30350n/spark-inducer/README.md

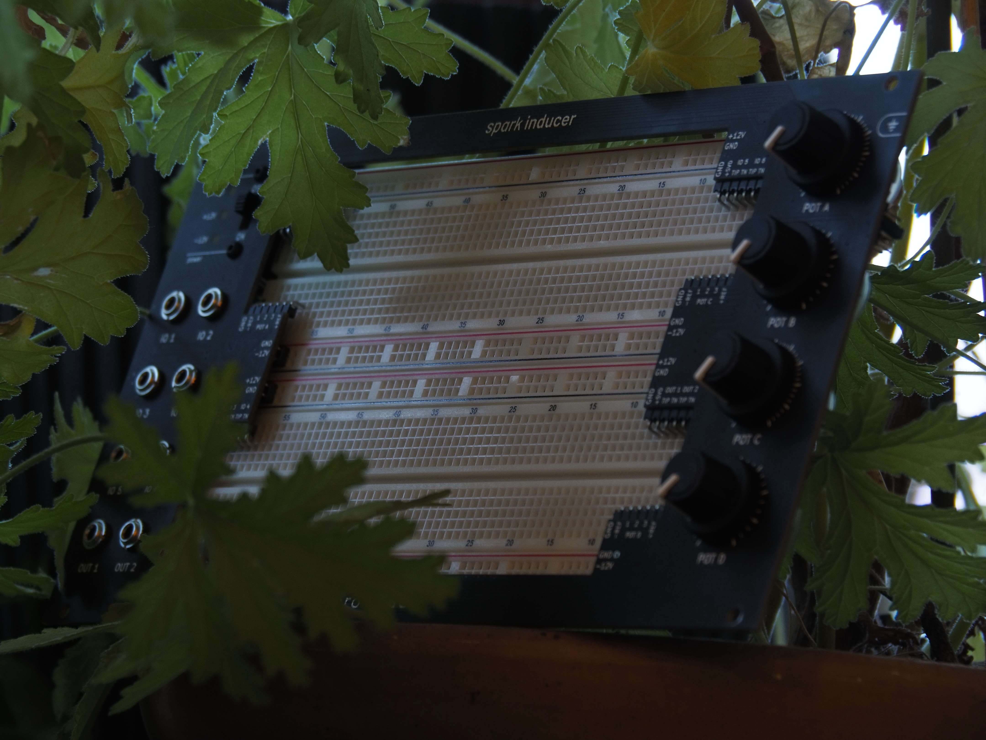
[picture p1: images/dev_C230025_assembled_nature.jpg]


### [More info](https://protorack.de/modules/spark-inducer)

### [Support me by buying a Kit at LECTRONZ!](https://lectronz.com/products/spark-inducer)
