30350n/spark-inducer/(threads)

Thread 1 (2024-02-17):

3D printed plastic bracket for power switch

drbloop, 2024-02-17:
Can you add a STL file for the power switch bracket to this repository? I am assembling spark-inducer from a PCB/panel set and am stuck on Step 3.1 in the assembly manual. I have access to a 3D printer, just need the STL file. Thank you.

30350n, 2024-02-21:
Hey, sorry for the late answer!

Here's the FreeCAD files, aswell as STL files for both Spacers. These should really be included in this repository, I'll add them the next days. Is will also include them with PCB/Panel Kits in the future, there's really no reason not to (I just didn't think of it).

[Spacer_GF-161-3011_M2-5_2.zip](https://github.com/30350n/spark-inducer/files/14365993/Spacer_GF-161-3011_M2-5_2.zip)
[Washer_RV16AF_2mm_3.zip](https://github.com/30350n/spark-inducer/files/14365982/Washer_RV16AF_2mm_3.zip)

drbloop, 2024-02-22:
Thank you, printed from these files and no problems - everything fits together perfectly.

30350n, 2024-02-23:
That's very nice to hear! If you run into any other issue with the build be sure to hit me up 😃

Thread 2 (2025-03-02):

LFO schematic?

unfrostedpoptart, 2025-03-02:
Hi.

I just got your kit and built it.  The main unit is fine but the LFO isn't working and I  can't find the schematic for it.  Where is it?

Thanks,

David

30350n, 2025-03-02:
Hi! The sources for the P-02 LFO are available [here](https://github.com/30350n/breadboard-helpers/tree/master/P-02_lfo).

If  you want you can also share a picture of it here, maybe I can spot something ^^

unfrostedpoptart, 2025-03-02:
Thanks, but those are all KiCAD files - which I don’t have. Don’t you have a PDF of the schematic?Sent from my iPhoneOn Mar 2, 2025, at 6:51 AM, Bobbe ***@***.***> wrote:
  Hi! The sources for the P-02 LFO are available here.
If  you want you can also share a picture of it here, maybe I can spot something ^^—Reply to this email directly, view it on GitHub, or unsubscribe.You are receiving this because you authored the thread.Message ID: ***@***.***>

30350n left a comment (30350n/spark-inducer#2)
Hi! The sources for the P-02 LFO are available here.
If  you want you can also share a picture of it here, maybe I can spot something ^^

—Reply to this email directly, view it on GitHub, or unsubscribe.You are receiving this because you authored the thread.Message ID: ***@***.***>

30350n, 2025-03-02:
Here you go: [P-02_lfo.pdf](https://github.com/user-attachments/files/19044056/P-02_lfo.pdf)

unfrostedpoptart, 2025-03-02:
thanksSent from my iPhoneOn Mar 2, 2025, at 9:25 AM, Bobbe ***@***.***> wrote:
  Here you go: P-02_lfo.pdf—Reply to this email directly, view it on GitHub, or unsubscribe.You are receiving this because you authored the thread.Message ID: ***@***.***>

30350n left a comment (30350n/spark-inducer#2)
Here you go: P-02_lfo.pdf

—Reply to this email directly, view it on GitHub, or unsubscribe.You are receiving this because you authored the thread.Message ID: ***@***.***>

Closed 2025-03-07.
