30350n/spark-inducer/manual/manual.pdf

## Potentiometers

!

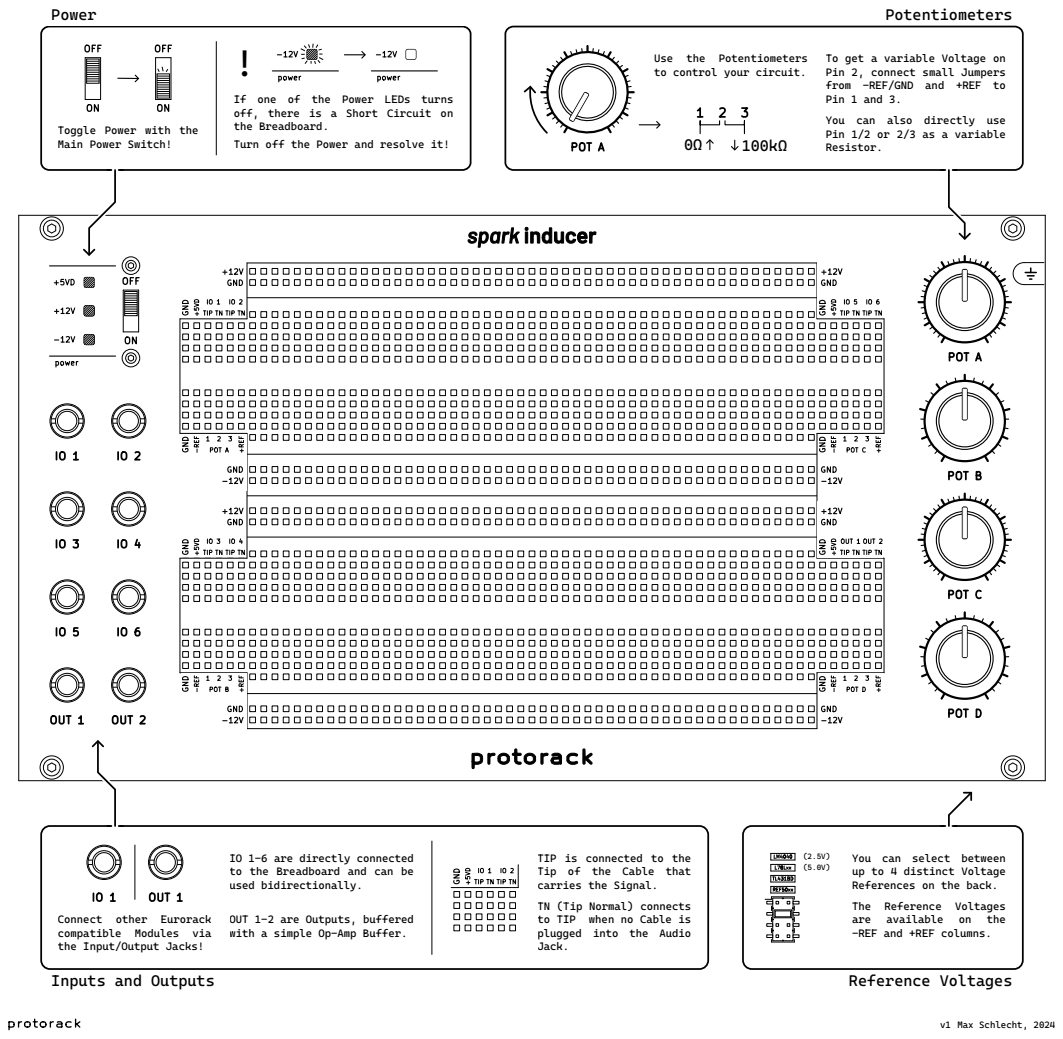
[picture p86: page 1]
v1 Max Schlecht, 2024; are; available; the; Reference Voltages; Resistor.; Power

Use the Potentiometers
to control your circuit.

To get a variable Voltage on
Pin 2, connect small Jumpers
from -REF/GND and +REF to
Pin 1 and 3.
You can also directly use
Pin 1/2 or 2/3 as a variable

If one of the Power LEDs turns
off, there is a Short Circuit on
the Breadboard.
Turn off the Power and resolve it!

Toggle Power with the
Main Power Switch!

IO 1-6 are directly connected
to the Breadboard and can be
used bidirectionally.

TIP is connected to the
Tip of the Cable that
carries the Signal.
TN (Tip Normal) connects
to TIP when no Cable is
plugged into the Audio
Jack.

You can select between
up to 4 distinct Voltage
References on the back.
The Reference Voltages
−REF and +REF columns.

Connect other Eurorack
compatible Modules via
the Input/Output Jacks!
Inputs and Outputs

OUT 1-2 are Outputs, buffered
with a simple Op-Amp Buffer.
