30350n/spark-inducer/manual/pdf/back_silkscreen.pdf

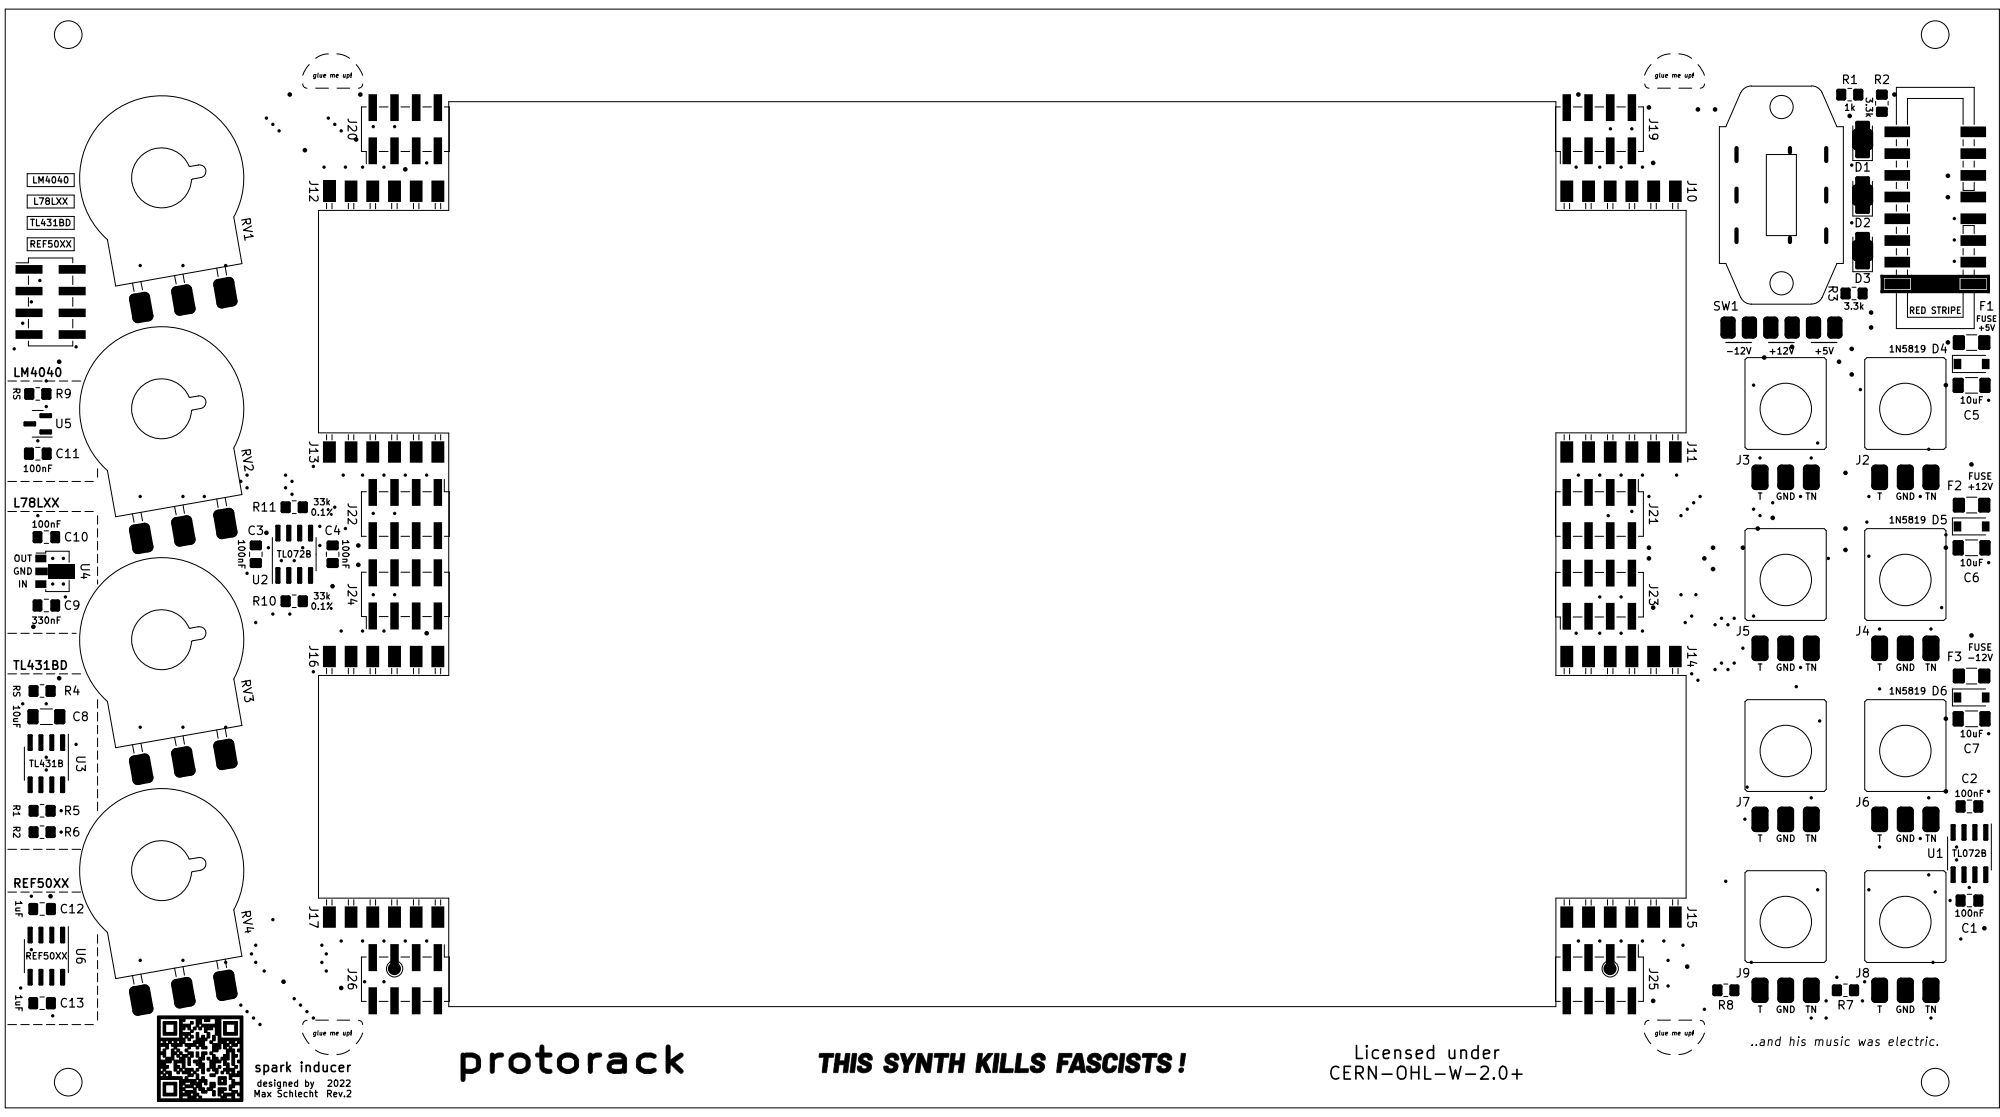
[picture p87: page 1]
