30350n/spark-inducer/manual/pdf/schematic.pdf

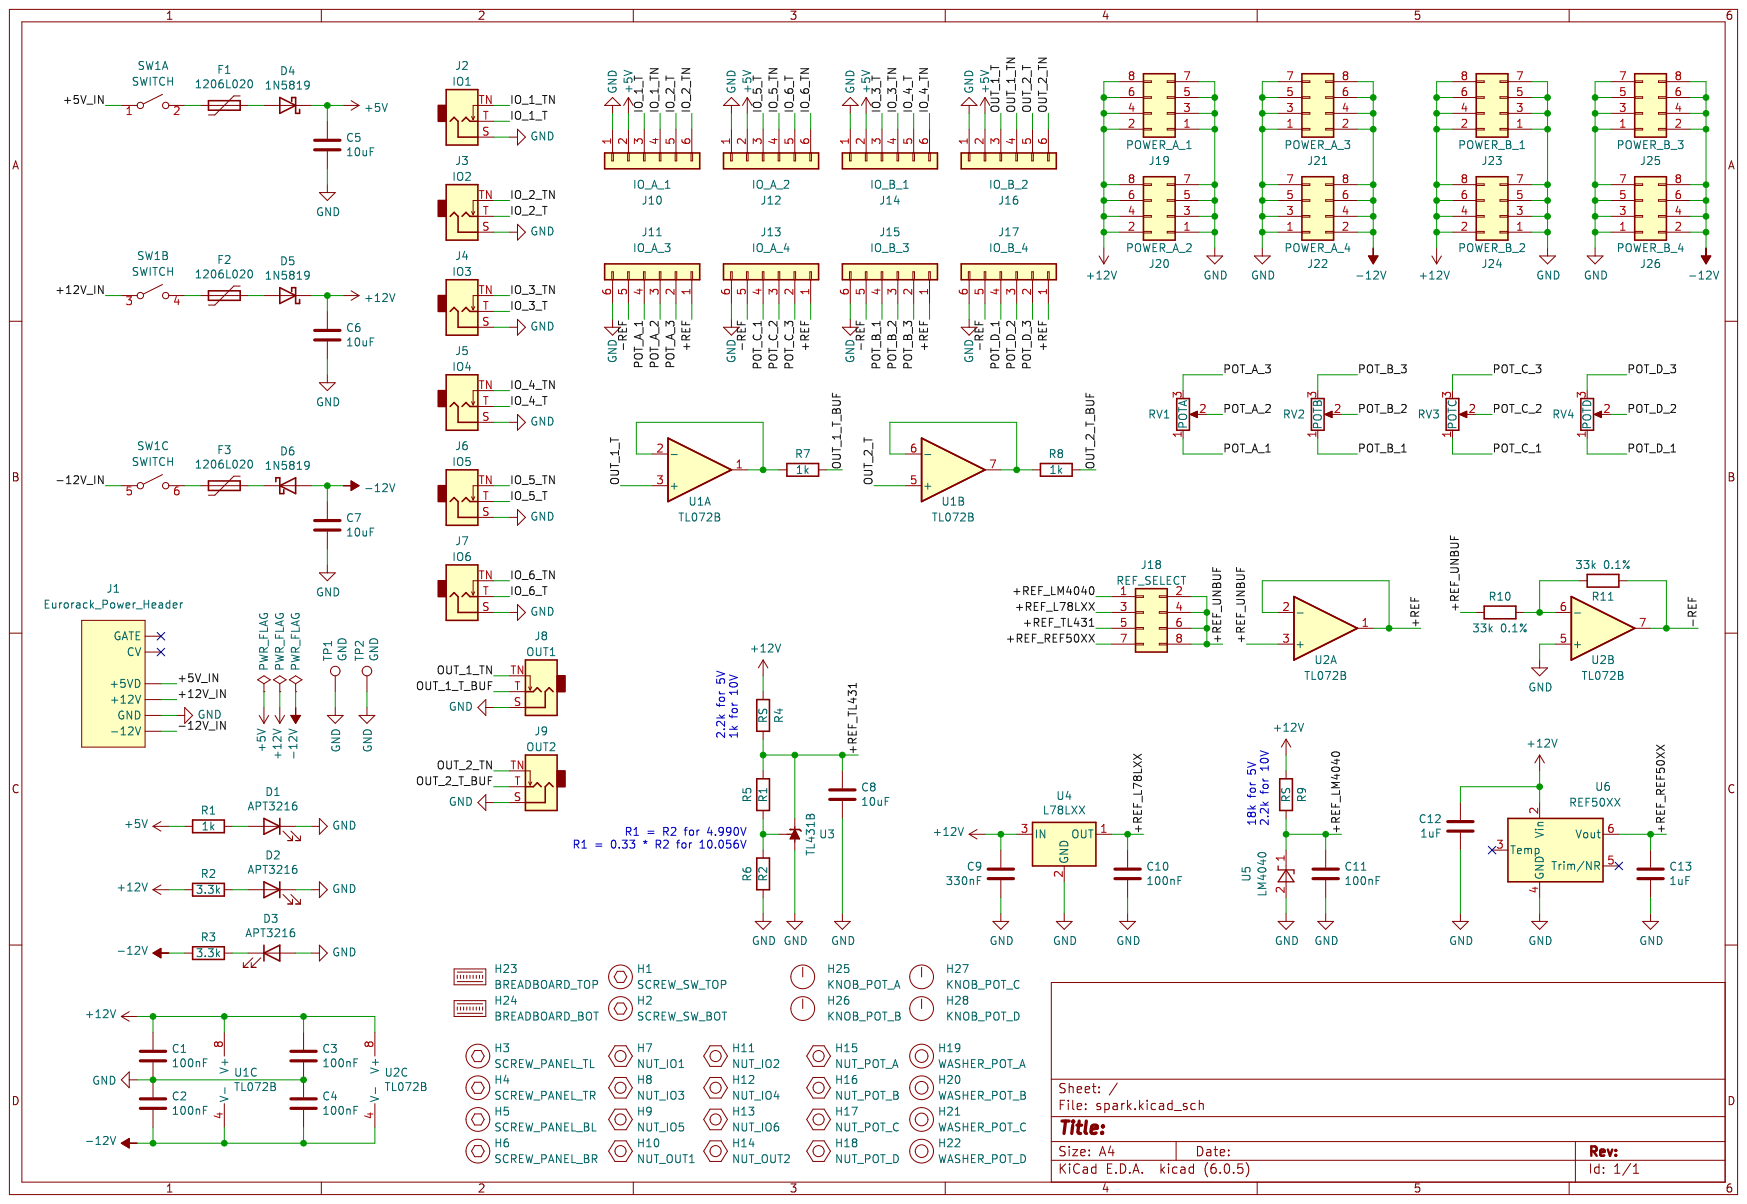
[picture p88: page 1]
