30350n/spark-inducer/helper-switch/helper-switch.kicad_pcb

## KiCad design helper-switch/helper-switch.kicad_pcb (2023-06-05)

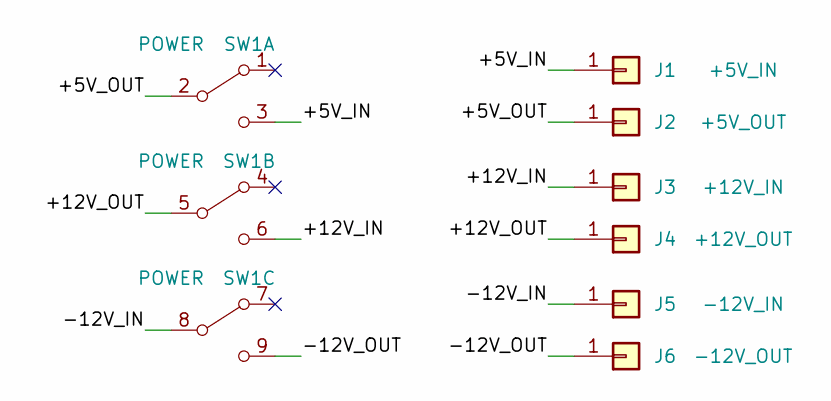
[picture p89: schematic helper-switch.kicad_sch]

Parts:
J1: +5V_IN; TestPoint_THTPad_1.8x1.8mm_Drill1.0mm
J2: +5V_OUT; TestPoint_THTPad_1.8x1.8mm_Drill1.0mm
J3: +12V_IN; TestPoint_THTPad_1.8x1.8mm_Drill1.0mm
J4: +12V_OUT; TestPoint_THTPad_1.8x1.8mm_Drill1.0mm
J5: -12V_IN; TestPoint_THTPad_1.8x1.8mm_Drill1.0mm
J6: -12V_OUT; TestPoint_THTPad_1.8x1.8mm_Drill1.0mm
SW1: POWER; CW_GF-161-3011

Connections:
/+5V_IN: J1.1, SW1.3 (C)
/+5V_OUT: J2.1, SW1.2 (B)
/+12V_IN: J3.1, SW1.6 (C)
/+12V_OUT: J4.1, SW1.5 (B)
/-12V_IN: J5.1, SW1.8 (B)
/-12V_OUT: J6.1, SW1.9 (C)

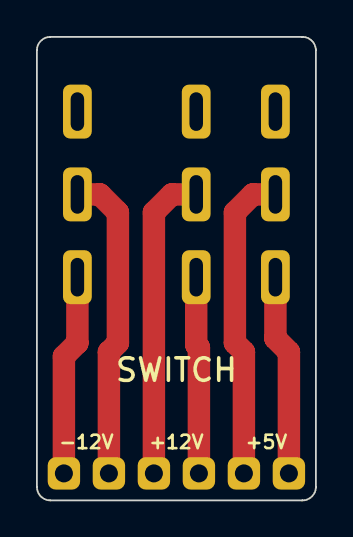
[picture p90: board helper-switch.kicad_pcb from above]

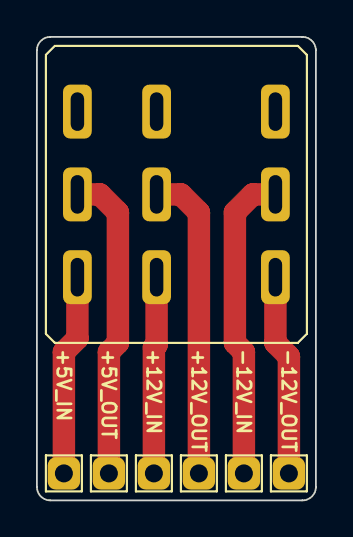
[picture p91: board helper-switch.kicad_pcb from below]

Board: 2 copper layers, 15.5 x 25.8 mm, 7 parts (7 on the bottom side), 6 nets.
