30350n/spark-inducer/helper-jack/helper-jack.kicad_pcb

## KiCad design helper-jack/helper-jack.kicad_pcb (2023-06-05)

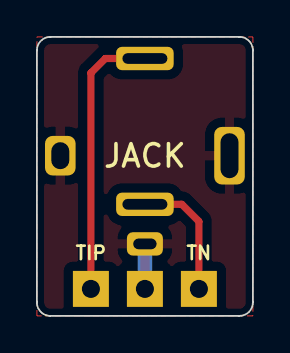
[picture p92: board helper-jack.kicad_pcb from above]

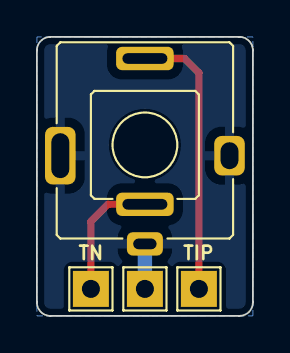
[picture p93: board helper-jack.kicad_pcb from below]

Board: 2 copper layers, 12.0 x 15.5 mm, 4 parts (4 on the bottom side), 3 nets.

Parts:
J1: S; TestPoint_THTPad_2.0x2.0mm_Drill1.0mm
J2: TIP; TestPoint_THTPad_2.0x2.0mm_Drill1.0mm
J3: TN; TestPoint_THTPad_2.0x2.0mm_Drill1.0mm
J4: WQP518MA-BM_Combined; QingPu_WQP-WQP518MA-BM_Combined

Connections:
/S: J1.1, J4.S
/T: J2.1, J4.T
/TN: J3.1, J4.TN
