30350n/spark-inducer/spark-inducer/spark-inducer.kicad_pcb

## KiCad design spark-inducer/spark-inducer.kicad_pcb (2023-06-04)

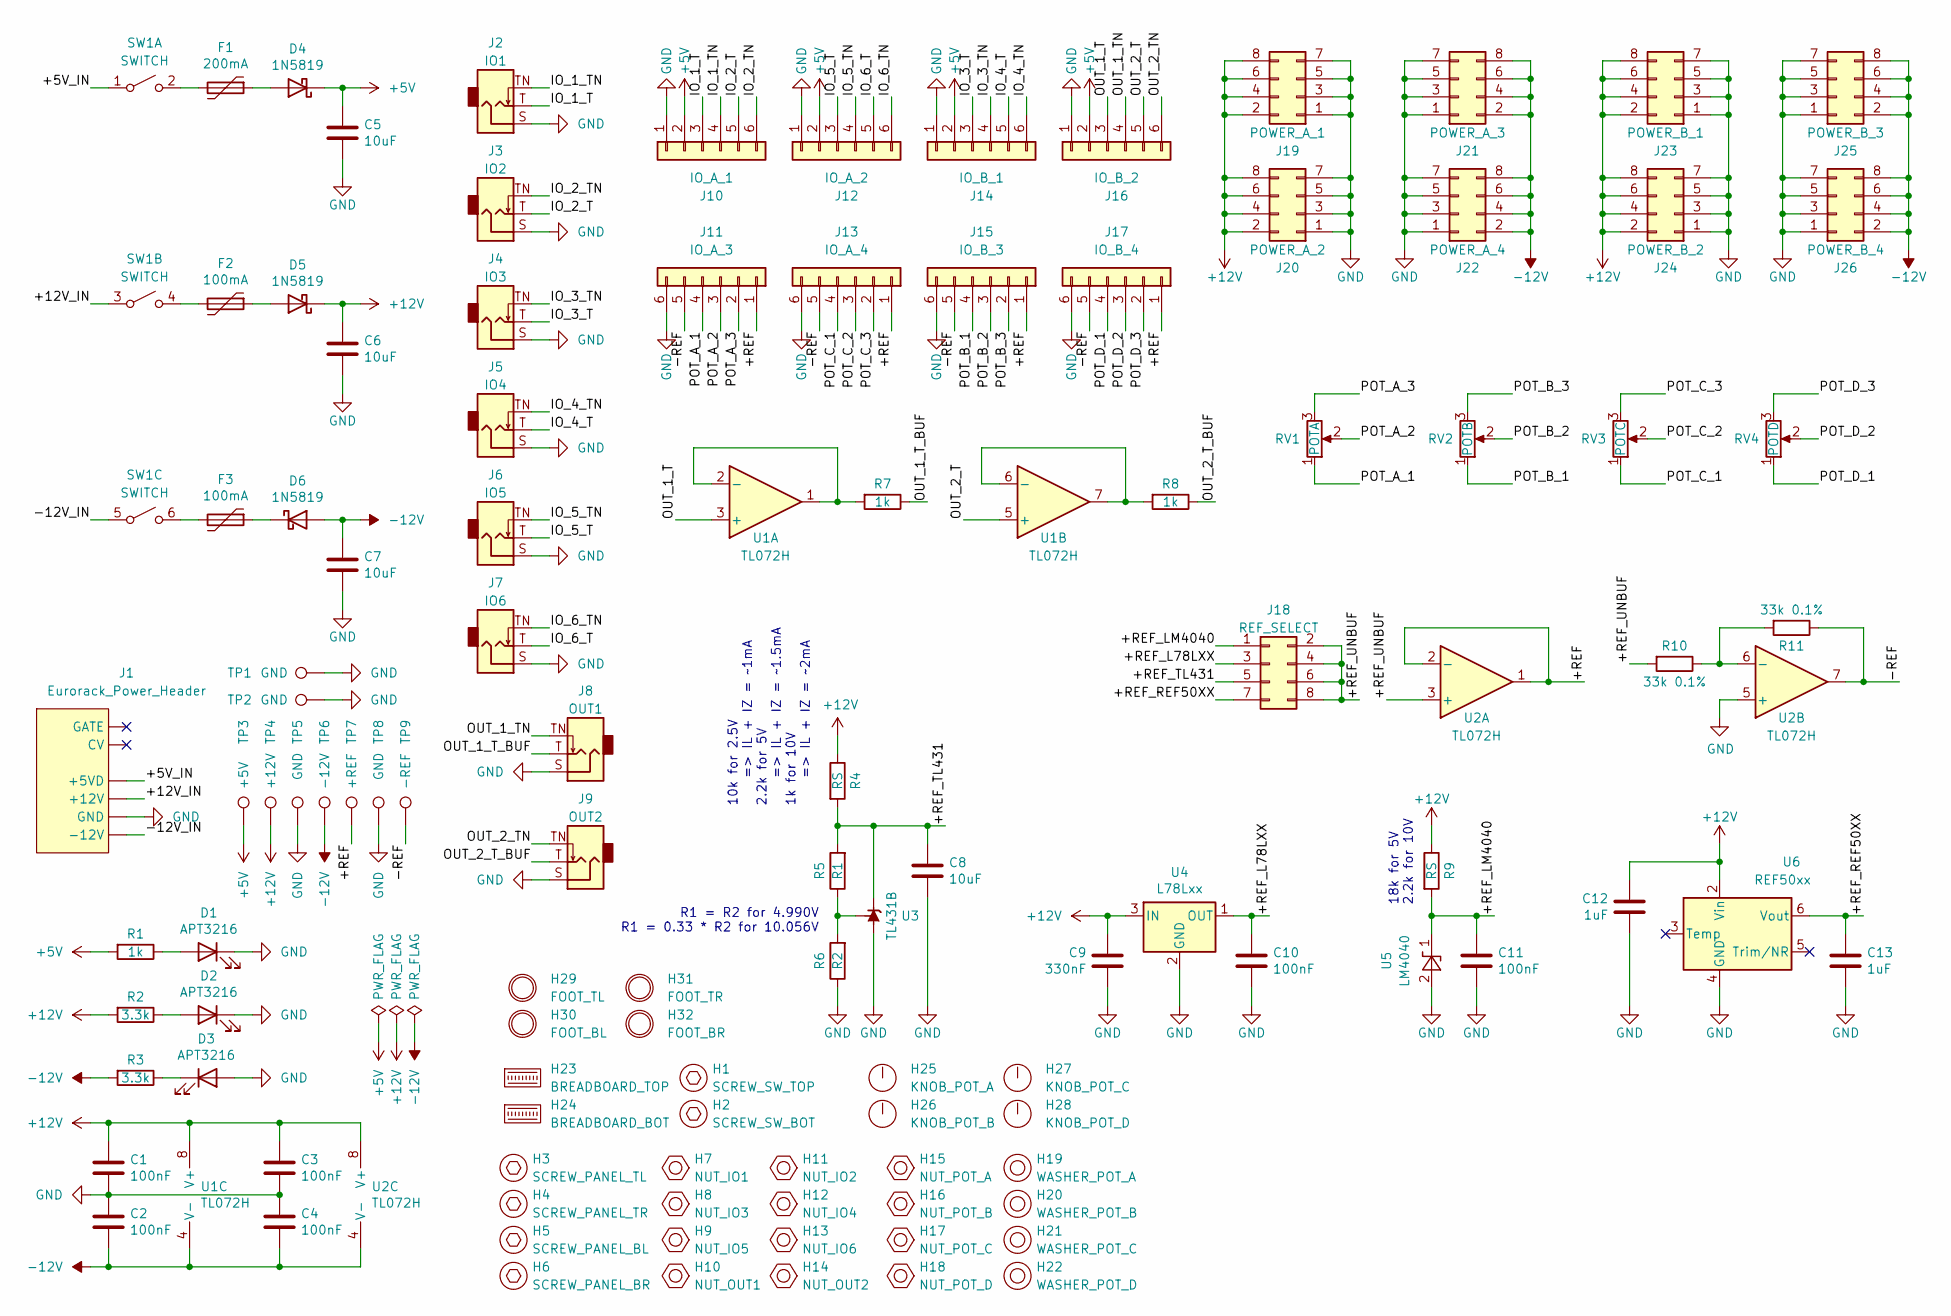
[picture p94: schematic spark-inducer.kicad_sch]

Parts:
C1, C2, C3, C4, C10, C11: 100nF; C_0805_2012Metric_Pad1.18x1.45mm_HandSolder
C5, C6, C7, C8: 10uF; C_1206_3216Metric_Pad1.33x1.80mm_HandSolder
C9: 330nF; C_0805_2012Metric_Pad1.18x1.45mm_HandSolder
C12, C13: 1uF; C_0805_2012Metric_Pad1.18x1.45mm_HandSolder
D1, D2, D3: APT3216; LED_1206_3216Metric_ReverseMount_HandSolder
D4, D5, D6: 1N5819; D_SOD-123
F1: 200mA; Fuse_1206_3216Metric_Pad1.42x1.75mm_HandSolder
F2, F3: 100mA; Fuse_1206_3216Metric_Pad1.42x1.75mm_HandSolder
H1: SCREW_SW_TOP; Screw_ISO7380_M2-5x6
H2: SCREW_SW_BOT; Screw_ISO7380_M2-5x6
H3: SCREW_PANEL_TL; Screw_ISO7380_M3x6
H4: SCREW_PANEL_TR; Screw_ISO7380_M3x6
H5: SCREW_PANEL_BL; Screw_ISO7380_M3x6
H6: SCREW_PANEL_BR; Screw_ISO7380_M3x6
H7: NUT_IO1; Nut_M6x2mm_Knurled
H8: NUT_IO3; Nut_M6x2mm_Knurled
H9: NUT_IO5; Nut_M6x2mm_Knurled
H10: NUT_OUT1; Nut_M6x2mm_Knurled
H11: NUT_IO2; Nut_M6x2mm_Knurled
H12: NUT_IO4; Nut_M6x2mm_Knurled
H13: NUT_IO6; Nut_M6x2mm_Knurled
H14: NUT_OUT2; Nut_M6x2mm_Knurled
H15: NUT_POT_A; Nut_M7x2mm_Black
H16: NUT_POT_B; Nut_M7x2mm_Black
H17: NUT_POT_C; Nut_M7x2mm_Black
H18: NUT_POT_D; Nut_M7x2mm_Black
H19: WASHER_POT_A; Washer_RV16AF_2mm_Tab
H20: WASHER_POT_B; Washer_RV16AF_2mm_Tab
H21: WASHER_POT_C; Washer_RV16AF_2mm_Tab
H22: WASHER_POT_D; Washer_RV16AF_2mm_Tab
H23: BREADBOARD_TOP; Breadboard_MB-102
H24: BREADBOARD_BOT; Breadboard_MB-102
H25: KNOB_POT_A; Sifam_3-03-TPN130-006
H26: KNOB_POT_B; Sifam_3-03-TPN130-006
H27: KNOB_POT_C; Sifam_3-03-TPN130-006
H28: KNOB_POT_D; Sifam_3-03-TPN130-006
H29: FOOT_TL; 3M_SJ-5023
H30: FOOT_BL; 3M_SJ-5023
H31: FOOT_TR; 3M_SJ-5023
H32: FOOT_BR; 3M_SJ-5023
J1: Eurorack_Power_Header; Eurorack_Power_Header_2x08_SMD_HandSolder
J2: IO1; QingPu_WQP-WQP518MA-BM_SMD
J3: IO2; QingPu_WQP-WQP518MA-BM_SMD
J4: IO3; QingPu_WQP-WQP518MA-BM_SMD
J5: IO4; QingPu_WQP-WQP518MA-BM_SMD
J6: IO5; QingPu_WQP-WQP518MA-BM_SMD
J7: IO6; QingPu_WQP-WQP518MA-BM_SMD
J8: OUT1; QingPu_WQP-WQP518MA-BM_SMD
J9: OUT2; QingPu_WQP-WQP518MA-BM_SMD
J10: IO_A_1; Samtec_TSW-106-09-T-S-RA_Shortened_SMD
J11: IO_A_3; Samtec_TSW-106-09-T-S-RA_Shortened_SMD
J12: IO_A_2; Samtec_TSW-106-09-T-S-RA_Shortened_SMD
J13: IO_A_4; Samtec_TSW-106-09-T-S-RA_Shortened_SMD
J14: IO_B_1; Samtec_TSW-106-09-T-S-RA_Shortened_SMD
J15: IO_B_3; Samtec_TSW-106-09-T-S-RA_Shortened_SMD
J16: IO_B_2; Samtec_TSW-106-09-T-S-RA_Shortened_SMD
J17: IO_B_4; Samtec_TSW-106-09-T-S-RA_Shortened_SMD
J18: REF_SELECT; PinHeader_2x04_P2.54mm_Vertical_SMD
J19: POWER_A_1; PinHeader_2x04_P2.54mm_Vertical_SMD
J20: POWER_A_2; PinHeader_2x04_P2.54mm_Vertical_SMD
J21: POWER_A_3; PinHeader_2x04_P2.54mm_Vertical_SMD
J22: POWER_A_4; PinHeader_2x04_P2.54mm_Vertical_SMD
J23: POWER_B_1; PinHeader_2x04_P2.54mm_Vertical_SMD
J24: POWER_B_2; PinHeader_2x04_P2.54mm_Vertical_SMD
J25: POWER_B_3; PinHeader_2x04_P2.54mm_Vertical_SMD
J26: POWER_B_4; PinHeader_2x04_P2.54mm_Vertical_SMD
R1, R7, R8: 1k; R_0805_2012Metric_Pad1.20x1.40mm_HandSolder
R2, R3: 3.3k; R_0805_2012Metric_Pad1.20x1.40mm_HandSolder
R4, R9: RS; R_0805_2012Metric_Pad1.20x1.40mm_HandSolder
R5: R1; R_0805_2012Metric_Pad1.20x1.40mm_HandSolder
R6: R2; R_0805_2012Metric_Pad1.20x1.40mm_HandSolder
R10, R11: 33k 0.1%; R_0805_2012Metric_Pad1.20x1.40mm_HandSolder
RV1: POTA; Alpha_RV16AF-10-17K_SMD_Slot
RV2: POTB; Alpha_RV16AF-10-17K_SMD_Slot
RV3: POTC; Alpha_RV16AF-10-17K_SMD_Slot
RV4: POTD; Alpha_RV16AF-10-17K_SMD_Slot
SW1: SWITCH; CW_GF-161-3011_SMD
TP1, TP2: GND; TestPoint_THTPad_D1.5mm_Drill0.7mm
TP3: +5V; TestPoint_Pad_D1.5mm
TP4: +12V; TestPoint_Pad_D1.5mm
TP5, TP8: GND; TestPoint_Pad_D1.5mm
TP6: -12V; TestPoint_Pad_D1.5mm
TP7: +REF; TestPoint_Pad_D1.5mm
TP9: -REF; TestPoint_Pad_D1.5mm
U1, U2: TL072H; SOIC-8_3.9x4.9mm_P1.27mm
U3: TL431B; SOIC-8_3.9x4.9mm_P1.27mm
U4: L78Lxx; SOT-89-3_ThermalReliefs
U5: LM4040; SOT-23
U6: REF50xx; SOIC-8_3.9x4.9mm_P1.27mm

Connections:
+5V: C5.1, D4.1 (K), J10.2, J12.2, J14.2, J16.2, R1.2, TP3.1
+12V: C1.1, C3.1, C6.1, C9.2, C12.2, D5.1 (K), J19.2, J19.4, J19.6, J19.8, J20.2, J20.4, J20.6, J20.8, J23.2, J23.4, J23.6, J23.8, J24.2, J24.4, J24.6, J24.8, R2.2, R4.1, R9.1, TP4.1, U1.8 (V+), U2.8 (V+), U4.3 (IN), U6.2 (Vin)
-12V: C2.2, C4.2, C7.1, D6.2 (A), J21.2, J21.4, J21.6, J21.8, J22.2, J22.4, J22.6, J22.8, J25.2, J25.4, J25.6, J25.8, J26.2, J26.4, J26.6, J26.8, R3.2, TP6.1, U1.4 (V-), U2.4 (V-)
/+5V_IN: J1.+5VD, SW1.1 (A)
/+12V_IN: J1.+12V, SW1.3 (A)
/+REF: J11.1, J13.1, J15.1, J17.1, TP7.1, U2.1, U2.2 (-)
/+REF_L78LXX: C10.2, J18.3, U4.1 (OUT)
/+REF_LM4040: C11.2, J18.1, R9.2, U5.1 (K)
/+REF_REF50XX: C13.2, J18.7, U6.6 (Vout)
/+REF_TL431: C8.2, J18.5, R4.2, R5.2, U3.1 (K)
/+REF_UNBUF: J18.2, J18.4, J18.6, J18.8, R10.2, U2.3 (+)
/-12V_IN: J1.-12V, SW1.5 (A)
/-REF: J11.5, J13.5, J15.5, J17.5, R11.1, TP9.1, U2.7
/IO_1_T: J2.T, J10.3
/IO_1_TN: J2.TN, J10.4
/IO_2_T: J3.T, J10.5
/IO_2_TN: J3.TN, J10.6
/IO_3_T: J4.T, J14.3
/IO_3_TN: J4.TN, J14.4
/IO_4_T: J5.T, J14.5
/IO_4_TN: J5.TN, J14.6
/IO_5_T: J6.T, J12.3
/IO_5_TN: J6.TN, J12.4
/IO_6_T: J7.T, J12.5
/IO_6_TN: J7.TN, J12.6
/OUT_1_T: J16.3, U1.3 (+)
/OUT_1_TN: J8.TN, J16.4
/OUT_1_T_BUF: J8.T, R7.1
/OUT_2_T: J16.5, U1.5 (+)
/OUT_2_TN: J9.TN, J16.6
/OUT_2_T_BUF: J9.T, R8.1
/POT_A_1: J11.4, RV1.1
/POT_A_2: J11.3, RV1.2
/POT_A_3: J11.2, RV1.3
/POT_B_1: J15.4, RV2.1
/POT_B_2: J15.3, RV2.2
/POT_B_3: J15.2, RV2.3
/POT_C_1: J13.4, RV3.1
/POT_C_2: J13.3, RV3.2
/POT_C_3: J13.2, RV3.3
/POT_D_1: J17.4, RV4.1
/POT_D_2: J17.3, RV4.2
/POT_D_3: J17.2, RV4.3
GND: C1.2, C2.1, C3.2, C4.1, C5.2, C6.2, C7.2, C8.1, C9.1, C10.1, C11.1, C12.1, C13.1, D1.1 (K), D2.1 (K), D3.2 (A), J1.GND, J2.S, J3.S, J4.S, J5.S, J6.S, J7.S, J8.S, J9.S, J10.1, J11.6, J12.1, J13.6, J14.1, J15.6, J16.1, J17.6, J19.1, J19.3, J19.5, J19.7, J20.1, J20.3, J20.5, J20.7, J21.1, J21.3, J21.5, J21.7, J22.1, J22.3, J22.5, J22.7, J23.1, J23.3, J23.5, J23.7, J24.1, J24.3, J24.5, J24.7, J25.1, J25.3, J25.5, J25.7, J26.1, J26.3, J26.5, J26.7, R6.1, TP1.1, TP2.1, TP5.1, TP8.1, U2.5 (+), U3.2 (A), U3.3 (A), U3.6 (A), U3.7 (A), U4.2 (GND), U5.2 (A), U6.4 (GND)
unnamed: D1.2 (A), R1.1
unnamed: D2.2 (A), R2.1
unnamed: D3.1 (K), R3.1
unnamed: D4.2 (A), F1.1
unnamed: D5.2 (A), F2.1
unnamed: D6.1 (K), F3.1
unnamed: F1.2, SW1.2 (B)
unnamed: F2.2, SW1.4 (B)
unnamed: F3.2, SW1.6 (B)
unnamed: R7.2, U1.1, U1.2 (-)
unnamed: R8.2, U1.6 (-), U1.7
unnamed: R10.1, R11.2, U2.6 (-)
unnamed: R5.1, R6.2, U3.8 (REF)

Notes on the sheet:
18k for 5V 2.2k for 10V
R1 = R2 for 4.990V R1 = 0.33 * R2 for 10.056V
10k for 2.5V => IL + IZ = ~1mA 2.2k for 5V => IL + IZ = ~1.5mA 1k for 10V => IL + IZ = ~2mA

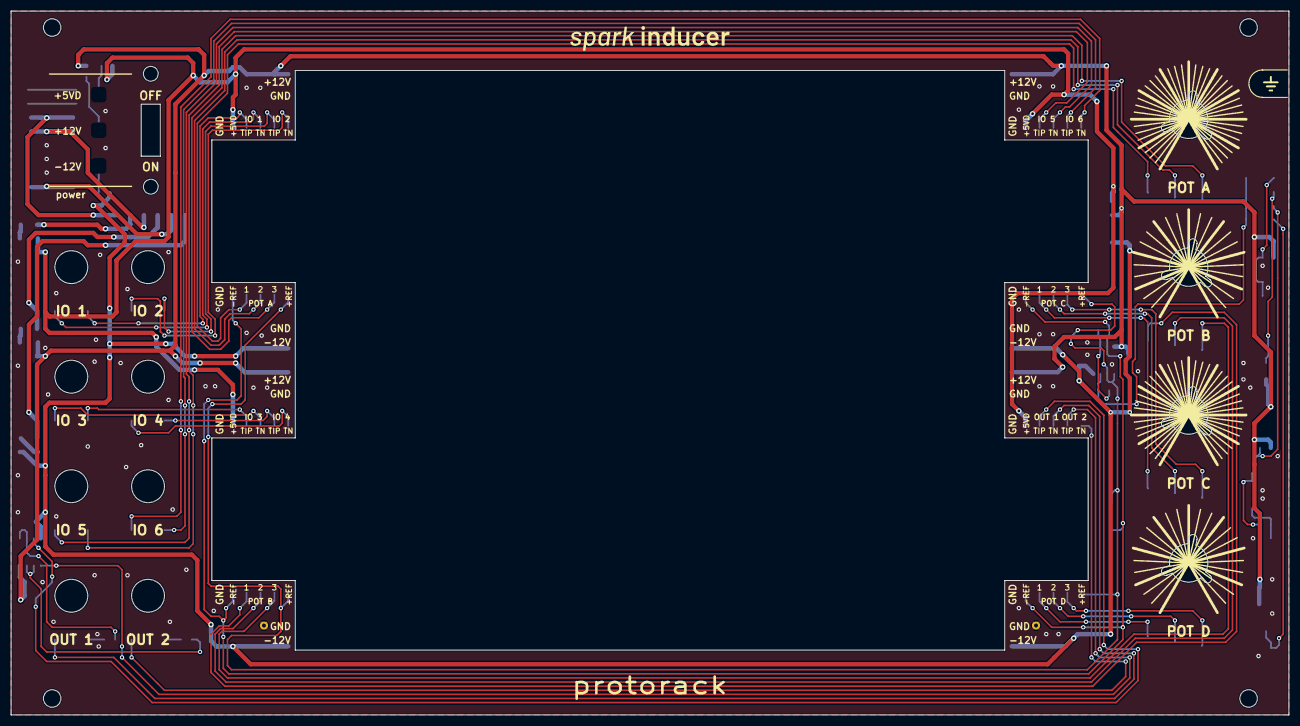
[picture p95: board spark-inducer.kicad_pcb from above]

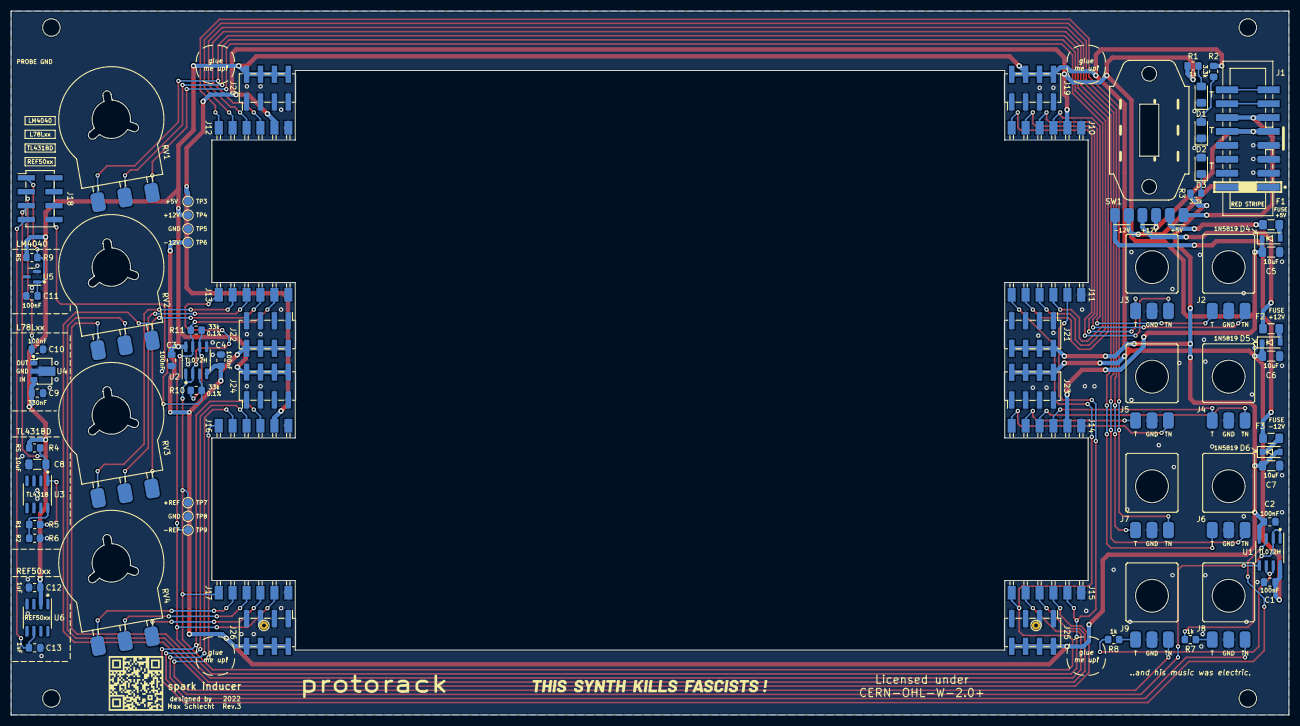
[picture p96: board spark-inducer.kicad_pcb from below]

Board: 2 copper layers, 233.3 x 128.5 mm, 116 parts (61 on the bottom side), 57 nets.

Other parts of the board:
Logo: LOGO; Logo_28x6mm
Logo_protorack: Logo_protorack
Logo_spark_inducer: Logo_spark_inducer
QRCode: Val**; QRCode_spark-inducer
TSKF: TSKF_44x4mm
