30350n/spark-inducer/(commit log)

2023-06-04 Add Rev.0 and Rev.1
    [spark-inducer.kicad_pcb, spark-inducer.sch, spark_old.kicad_pcb, spark_old.sch]
2023-06-04 Update to KiCad 6
    [spark-inducer.kicad_pcb, spark-inducer.kicad_sch, spark-inducer.sch]
2023-06-04 Remove legacy files
    [spark_old.kicad_pcb, spark_old.sch]
2023-06-04 Add switch and jack helpers
    [helper-jack.kicad_pcb, helper-jack.kicad_sch, helper-switch.kicad_pcb, helper-switch.kicad_sch]
2023-06-04 Update all footprints, use new custom footprints
    [spark-inducer.kicad_pcb, spark-inducer.kicad_sch]
2023-06-04 Add larger margin to copper layer next to led windows
    [spark-inducer.kicad_pcb]
2023-06-04 Fix breadboard spacings, Add glue marks
    [spark-inducer.kicad_pcb, spark-inducer.kicad_sch]
2023-06-04 Add new logos, Finalize silkscreen
    [spark-inducer.kicad_pcb]
2023-06-04 Add knobs
    [spark-inducer.kicad_pcb, spark-inducer.kicad_sch]
2023-06-04 Update qr code
    [spark-inducer.kicad_pcb]
2023-06-04 Add manual
    [bom.csv]
2023-06-04 Add ground clip attachment point, test points, rubber feet
    [spark-inducer.kicad_pcb, spark-inducer.kicad_sch]
2023-06-04 Update files to KiCad 7, Fix edge clearance, Add more spokes to washers
    [spark-inducer.kicad_pcb, spark-inducer.kicad_sch]
2023-06-05 Add markings to switch and jack helpers
    [helper-jack.kicad_pcb, helper-switch.kicad_pcb]
2023-06-05 Update helper jack to KiCad 7, Adjust markings, jack footprint
    [helper-jack.kicad_pcb, helper-jack.kicad_sch]
2023-06-05 Fix helper jack copper edge clearance for v-cuts
    [helper-jack.kicad_pcb]
2023-06-05 Update helper switch to KiCad 7, Adjust markings
    [helper-switch.kicad_pcb, helper-switch.kicad_sch]
2023-11-23 Add LM4040 soldering guide, rephrase L78Lxx section
2023-11-23 Add notes about using alternative voltage references to appendix
2023-11-23 Get rid of apostrophes, clarify switch soldering guide
2023-12-02 Particularize components (1/4W resistors, 1N5819HW diodes, TL431B)
2023-12-15 Fix LM4040 bias resistor note
2023-12-15 Add TL431B, REF50xx assembly sections
2023-12-15 Refactor power headers, testing, potentiometers, breadboards sections
2023-12-15 Add extra placeholder pictures for switch section
2023-12-15 Add SMD soldering intro
2023-12-24 Update component codes, Rename TL072B to TL072H, Fix fuses
2024-01-11 Update BOM
    [bom.csv]
2024-01-16 Add description column to bom
    [bom.csv]
2024-01-16 Add components for P-02 LFO bag to bom
    [bom.csv]
2024-01-18 Fix assembly_manual name
2024-01-19 Add descriptions to BOM, fix substitution criteria
    [bom.csv]
